domaug/Fightstick-Stuff/Modular Fightstick Stand/3D Print Files/Hinge Pad_2in.STL

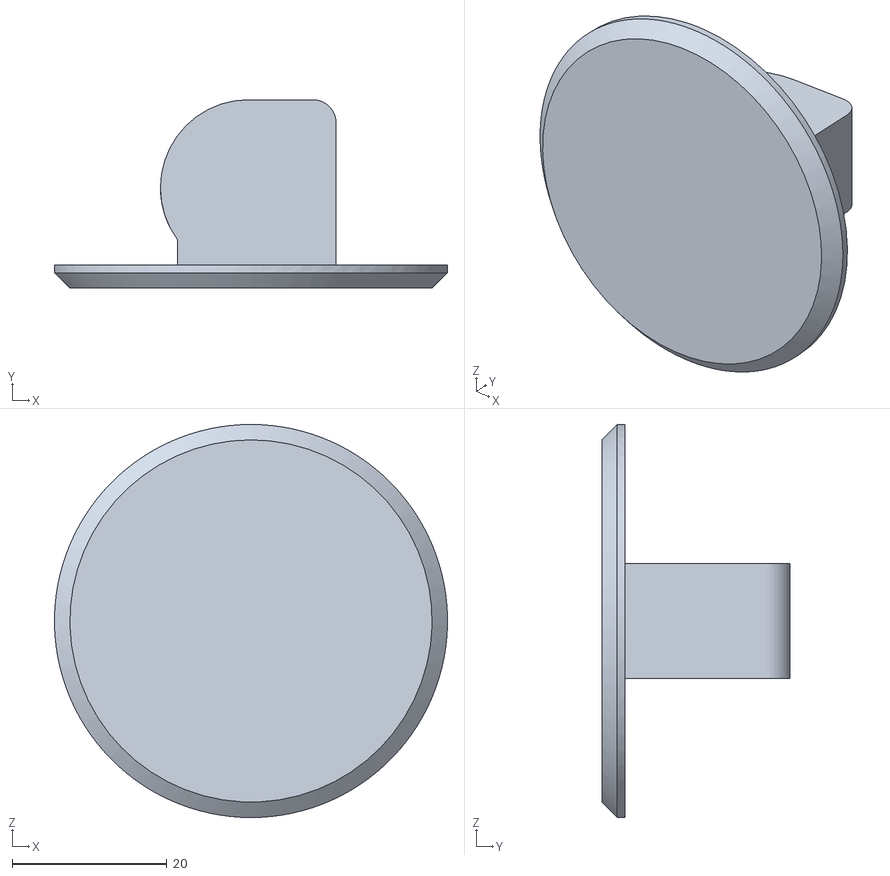
[picture p1: CAD file, 2024-09-08]
Modular Fightstick Stand/3D Print Files/Hinge Pad_2in.STL
50.8 x 24.4 x 50.8
