domaug/Fightstick-Stuff/PRISM Products/Modular Fightstick Stand - PRISM Edition/stand leg_prism.STL

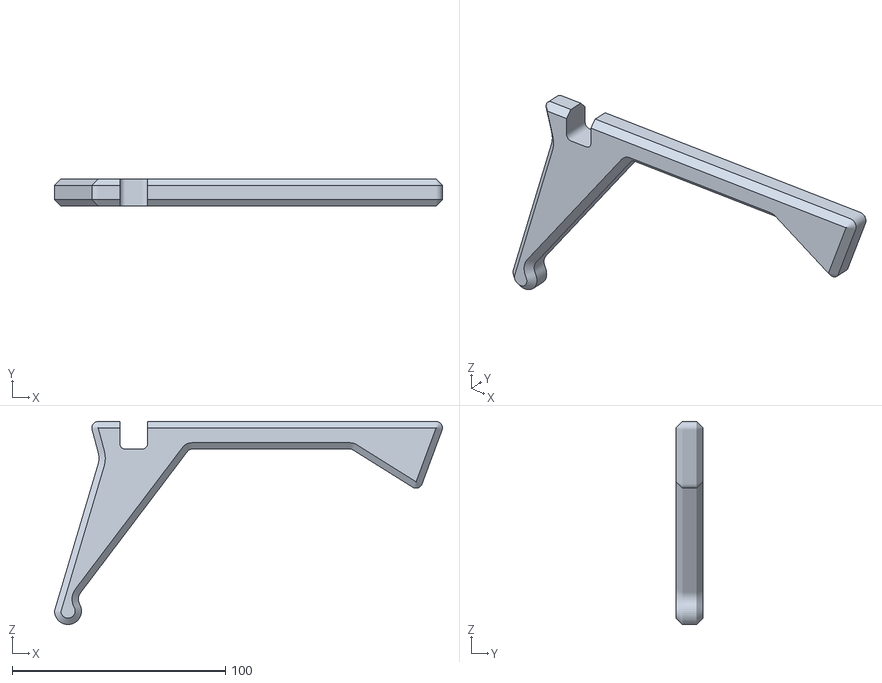
[picture p2: CAD file, 2024-08-22]
PRISM Products/Modular Fightstick Stand - PRISM Edition/stand leg_prism.STL
182.0 x 12.7 x 95.2
