domaug/Fightstick-Stuff/PRISM Products/PRISM Podium/PRISM Podium.STL

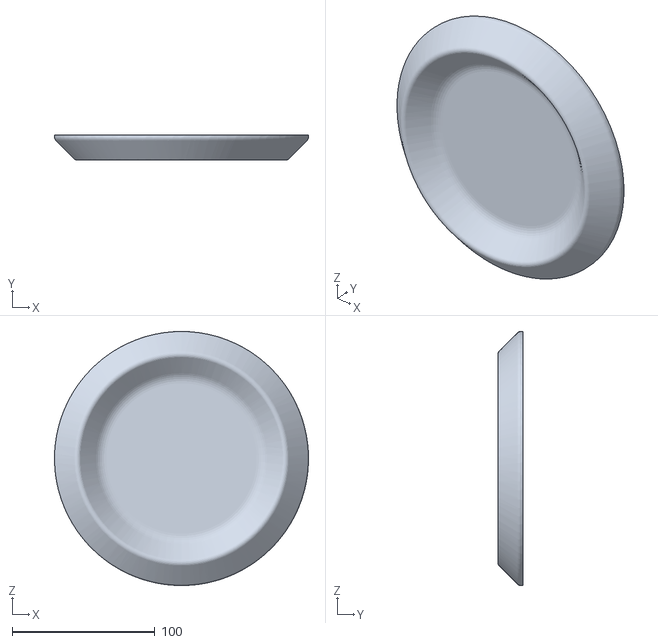
[picture p3: CAD file, 2024-08-22]
PRISM Products/PRISM Podium/PRISM Podium.STL
177.7 x 17.8 x 177.8
