domaug/Fightstick-Stuff/Modular Fightstick Stand/3D Print Files/Hinge Pad_1.25in.STL

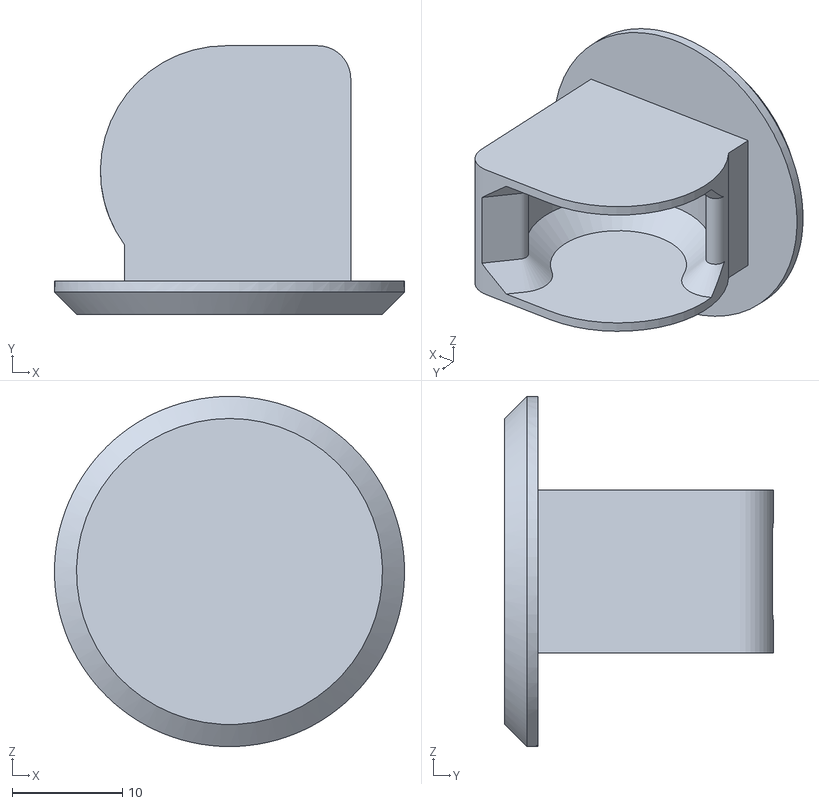
[picture p4: CAD file, 2024-09-08]
Modular Fightstick Stand/3D Print Files/Hinge Pad_1.25in.STL
31.7 x 24.4 x 31.8
