domaug/Fightstick-Stuff/PRISM Products/Modular Fightstick Stand - PRISM Edition/modular spine_2.5in.STL

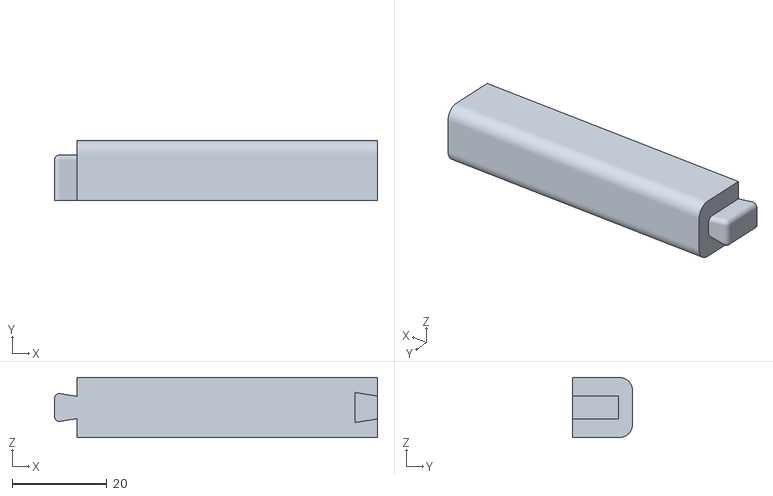
[picture p5: CAD file, 2024-08-22]
PRISM Products/Modular Fightstick Stand - PRISM Edition/modular spine_2.5in.STL
68.2 x 12.7 x 12.7
