domaug/Fightstick-Stuff/Modular Fightstick Stand/3D Print Files/Endcap_Male&Female.STL

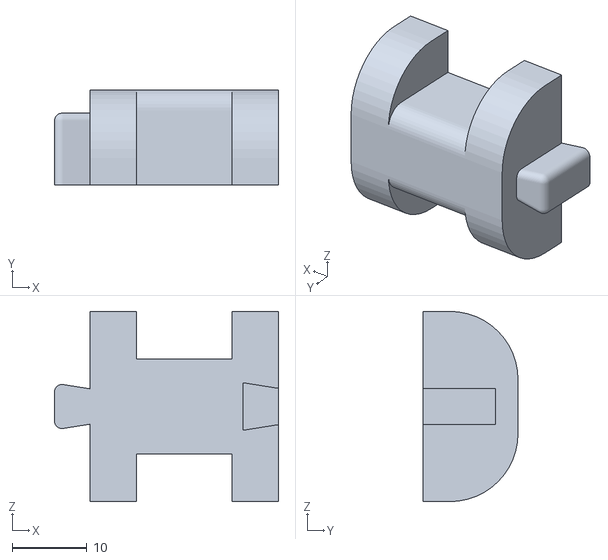
[picture p7: CAD file, 2024-08-12]
Modular Fightstick Stand/3D Print Files/Endcap_Male&Female.STL
29.9 x 12.7 x 25.4
