domaug/Fightstick-Stuff/Modular Fightstick Stand/3D Print Files/Spine_6 inch.STL

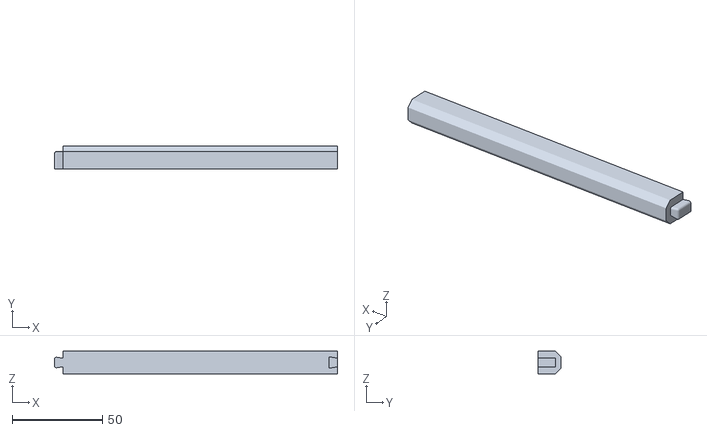
[picture p8: CAD file, 2024-08-12]
Modular Fightstick Stand/3D Print Files/Spine_6 inch.STL
157.1 x 12.7 x 12.7
