domaug/Fightstick-Stuff/Modular Fightstick Stand/3D Print Files/Spine_4 inch.STL

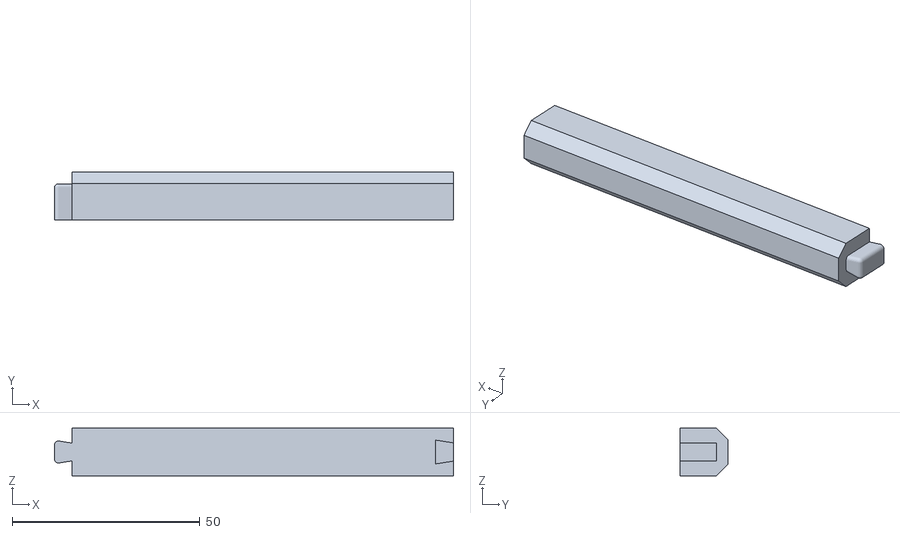
[picture p9: CAD file, 2024-08-12]
Modular Fightstick Stand/3D Print Files/Spine_4 inch.STL
106.3 x 12.7 x 12.7
