domaug/Fightstick-Stuff/Modular Fightstick Stand/3D Print Files/Leg-Lower_standard.STL

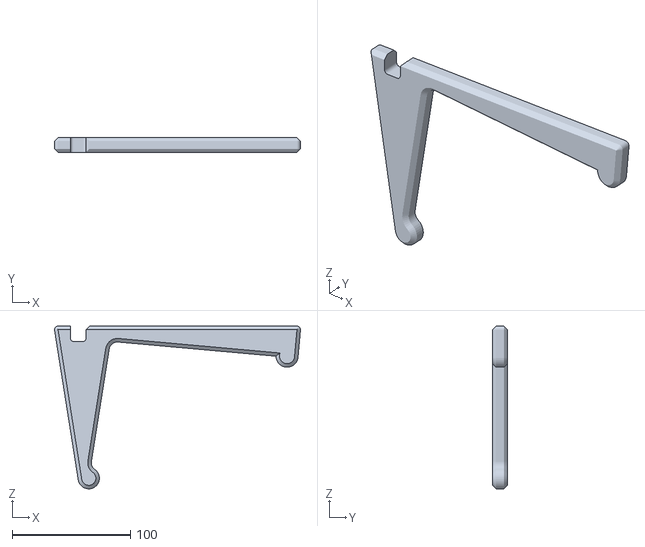
[picture p10: CAD file, 2024-08-12]
Modular Fightstick Stand/3D Print Files/Leg-Lower_standard.STL
207.7 x 12.7 x 137.4
