domaug/Fightstick-Stuff/Modular Fightstick Stand/3D Print Files/Leg-Lower_extended tip.STL

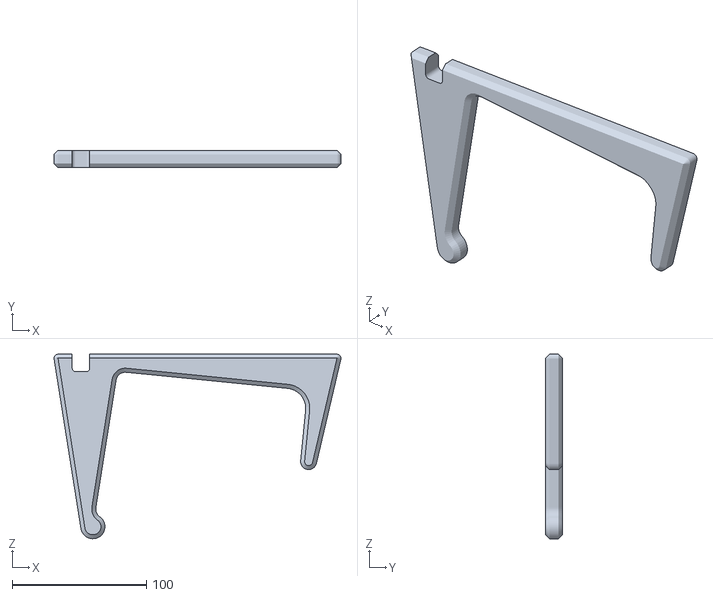
[picture p11: CAD file, 2024-08-12]
Modular Fightstick Stand/3D Print Files/Leg-Lower_extended tip.STL
213.7 x 12.7 x 137.4
