domaug/Fightstick-Stuff/Modular Fightstick Stand/3D Print Files/Leg_standard.STL

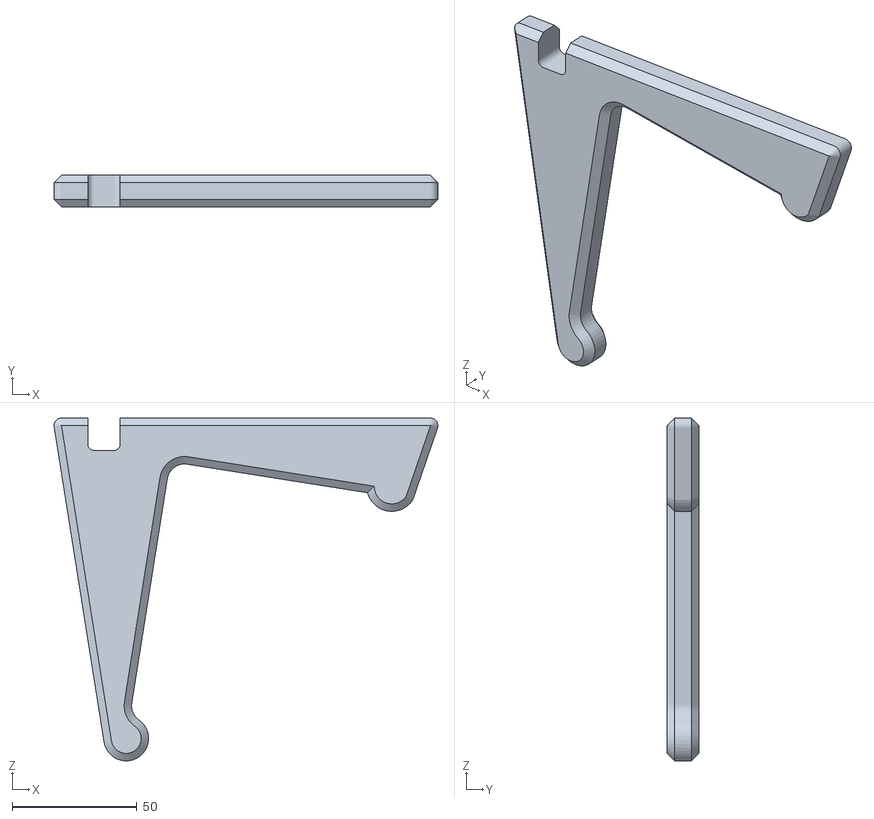
[picture p12: CAD file, 2024-08-11]
Modular Fightstick Stand/3D Print Files/Leg_standard.STL
153.9 x 12.7 x 137.4
