domaug/Fightstick-Stuff/Modular Fightstick Stand/3D Print Files/Leg_extended tip.STL

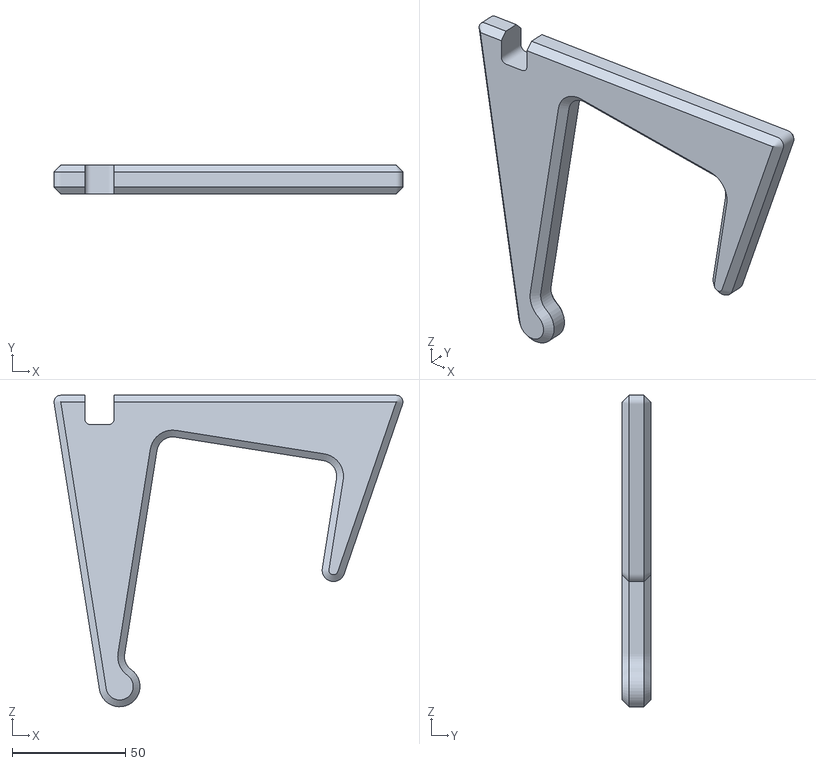
[picture p13: CAD file, 2024-08-11]
Modular Fightstick Stand/3D Print Files/Leg_extended tip.STL
153.9 x 12.7 x 137.4
