domaug/Fightstick-Stuff/Modular Fightstick Stand/3D Print Files/Leg_shortened.STL

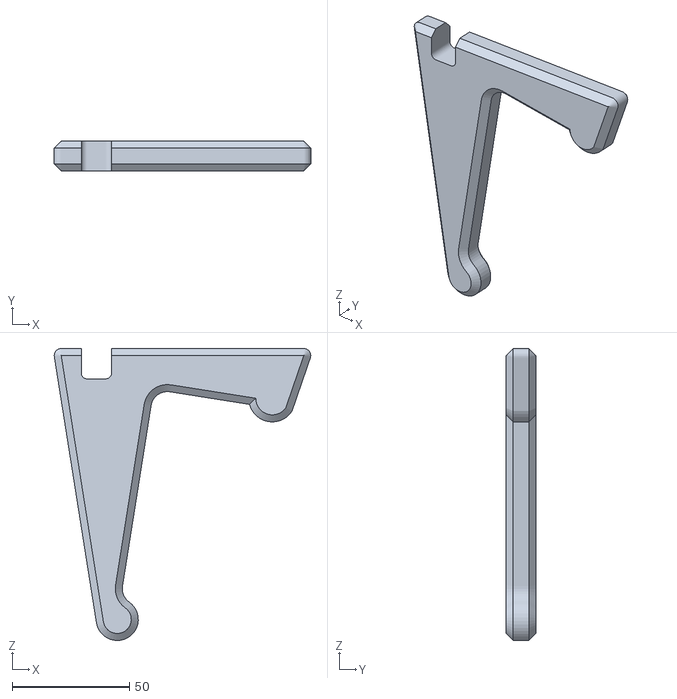
[picture p14: CAD file, 2024-08-11]
Modular Fightstick Stand/3D Print Files/Leg_shortened.STL
109.6 x 12.7 x 124.7
