domaug/Fightstick-Stuff/Modular Fightstick Stand/3D Print Files/Endcap_Female.STL

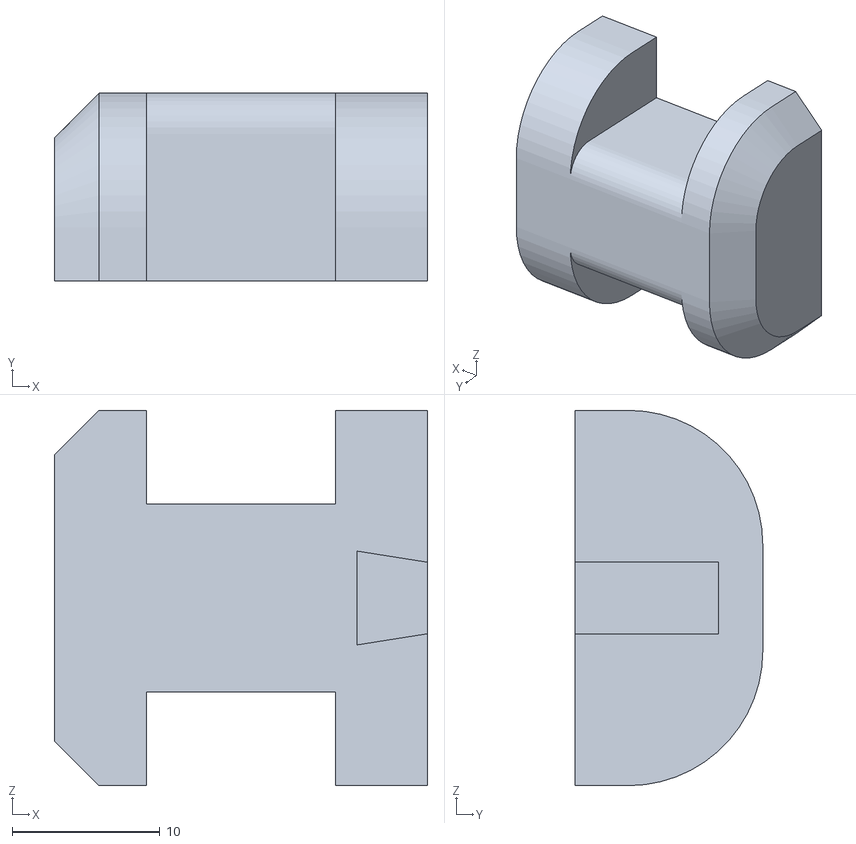
[picture p15: CAD file, 2024-08-11]
Modular Fightstick Stand/3D Print Files/Endcap_Female.STL
25.2 x 12.7 x 25.4
