domaug/Fightstick-Stuff/Modular Fightstick Stand/3D Print Files/README

This folder contains .STL format files of all of the modular stand components, ready for 3D printing.
