domaug/Fightstick-Stuff/(commit log)

2024-08-29 Changed location of "PRISM Products" folder
    [PRISM Podium.STL, modular spine_2.5in.STL, stand leg_prism.STL]
2024-09-07 Added section "Foam-Saving Hinge Pads (Optional)"
2024-09-08 Uploaded files for Hinge Pads
    [Hinge Pad_1.25in.STEP, Hinge Pad_1.25in.STL, Hinge Pad_2in.STEP, Hinge Pad_2in.STL]
